rambo42689/Sensor-Estatico/Suporte do Sensor na Bancada (Projeto SOLID)/Suporte Pronto - Bancada Estática.SLDASM

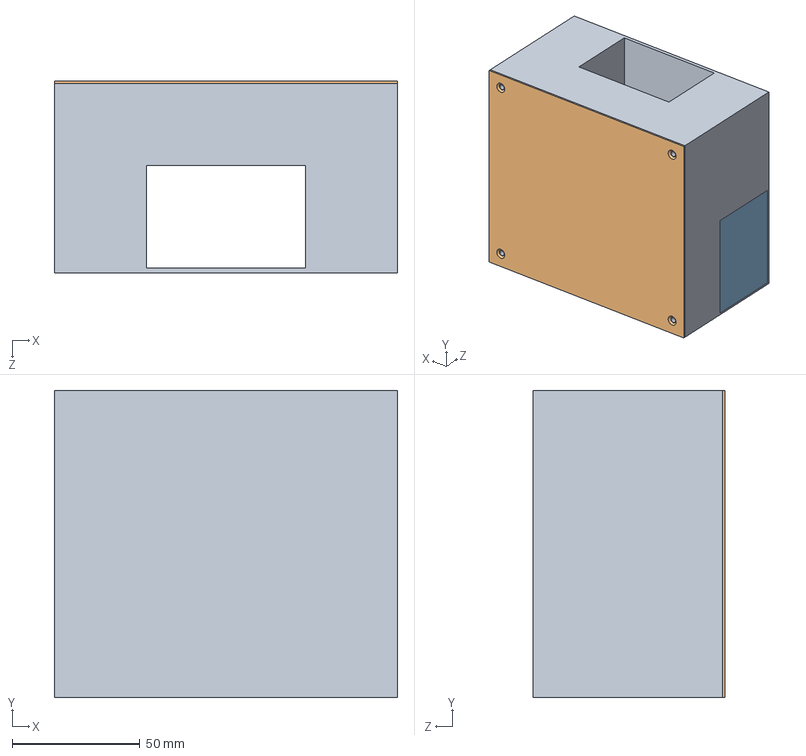
[picture p1: CAD file, 2019-11-12]
Suporte do Sensor na Bancada (Projeto SOLID)/Suporte Pronto - Bancada Estática.SLDASM
134.0 x 120.0 x 75.0 mm
Caixa Principal - Bancada Estática
Tampa Traseira - Bancada Estática
Tampa - Pilha
