rambo42689/Sensor-Estatico/Suporte do Sensor na Bancada (Projeto SOLID)/Caixa Principal - Bancada Estática.SLDPRT

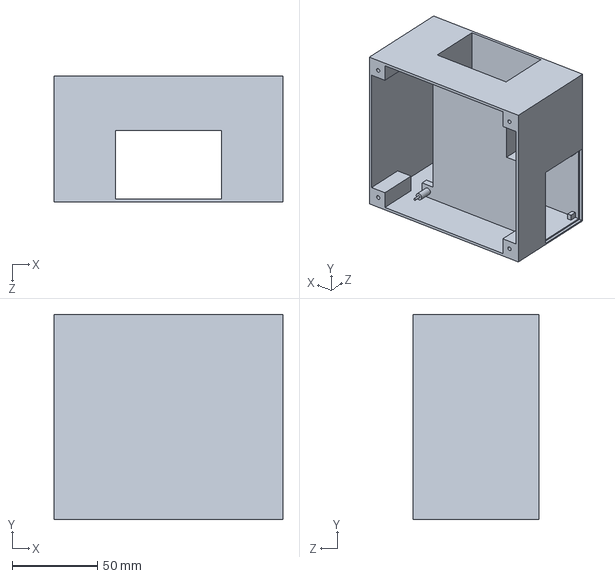
[picture p2: CAD file, 2019-11-12]
Suporte do Sensor na Bancada (Projeto SOLID)/Caixa Principal - Bancada Estática.SLDPRT
134.0 x 120.0 x 74.0 mm
