rambo42689/Sensor-Estatico/Suporte do Sensor na Bancada (Projeto SOLID)/Tampa - Pilha.SLDPRT

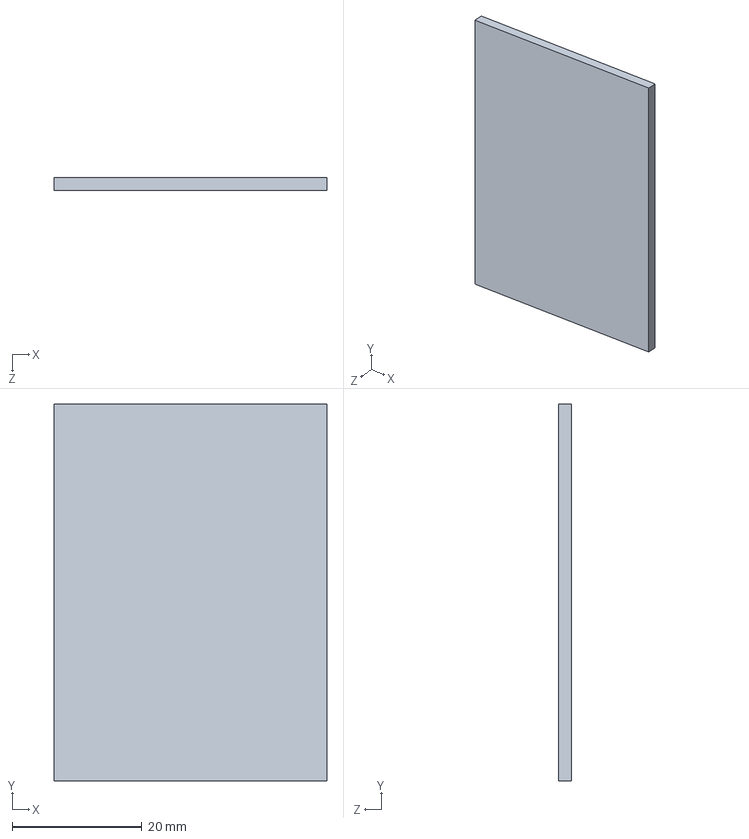
[picture p3: CAD file, 2019-11-12]
Suporte do Sensor na Bancada (Projeto SOLID)/Tampa - Pilha.SLDPRT
42.0 x 58.0 x 2.00 mm
