rambo42689/Sensor-Estatico/Suporte do Sensor na Bancada (Projeto SOLID)/Tampa Traseira - Bancada Estática.SLDPRT

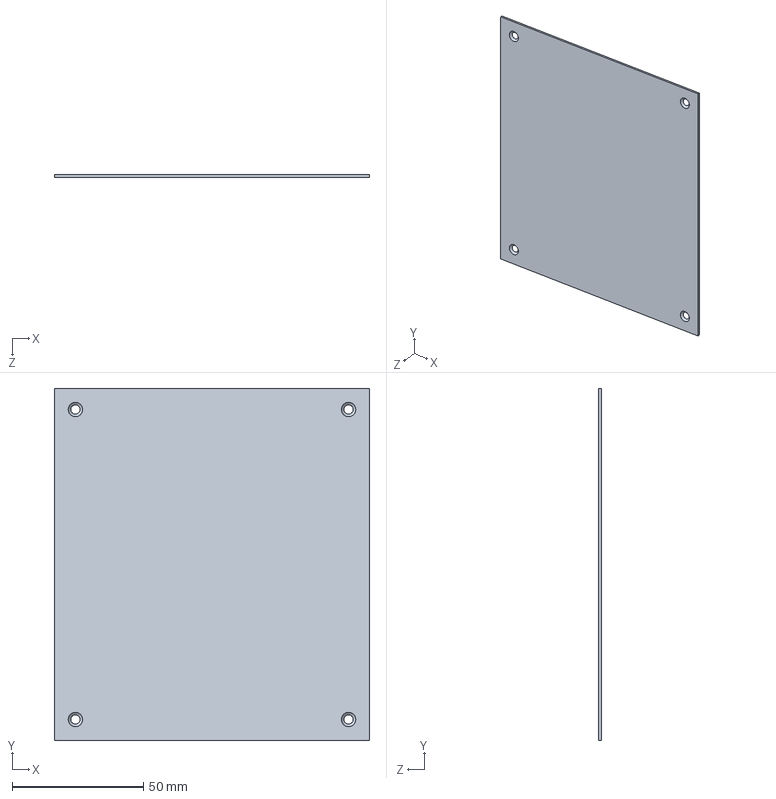
[picture p4: CAD file, 2019-11-12]
Suporte do Sensor na Bancada (Projeto SOLID)/Tampa Traseira - Bancada Estática.SLDPRT
120.0 x 134.0 x 1.00 mm
