rambo42689/Sensor-Estatico/PCB/Design-PCB---Impresso---4-Placas.pdf

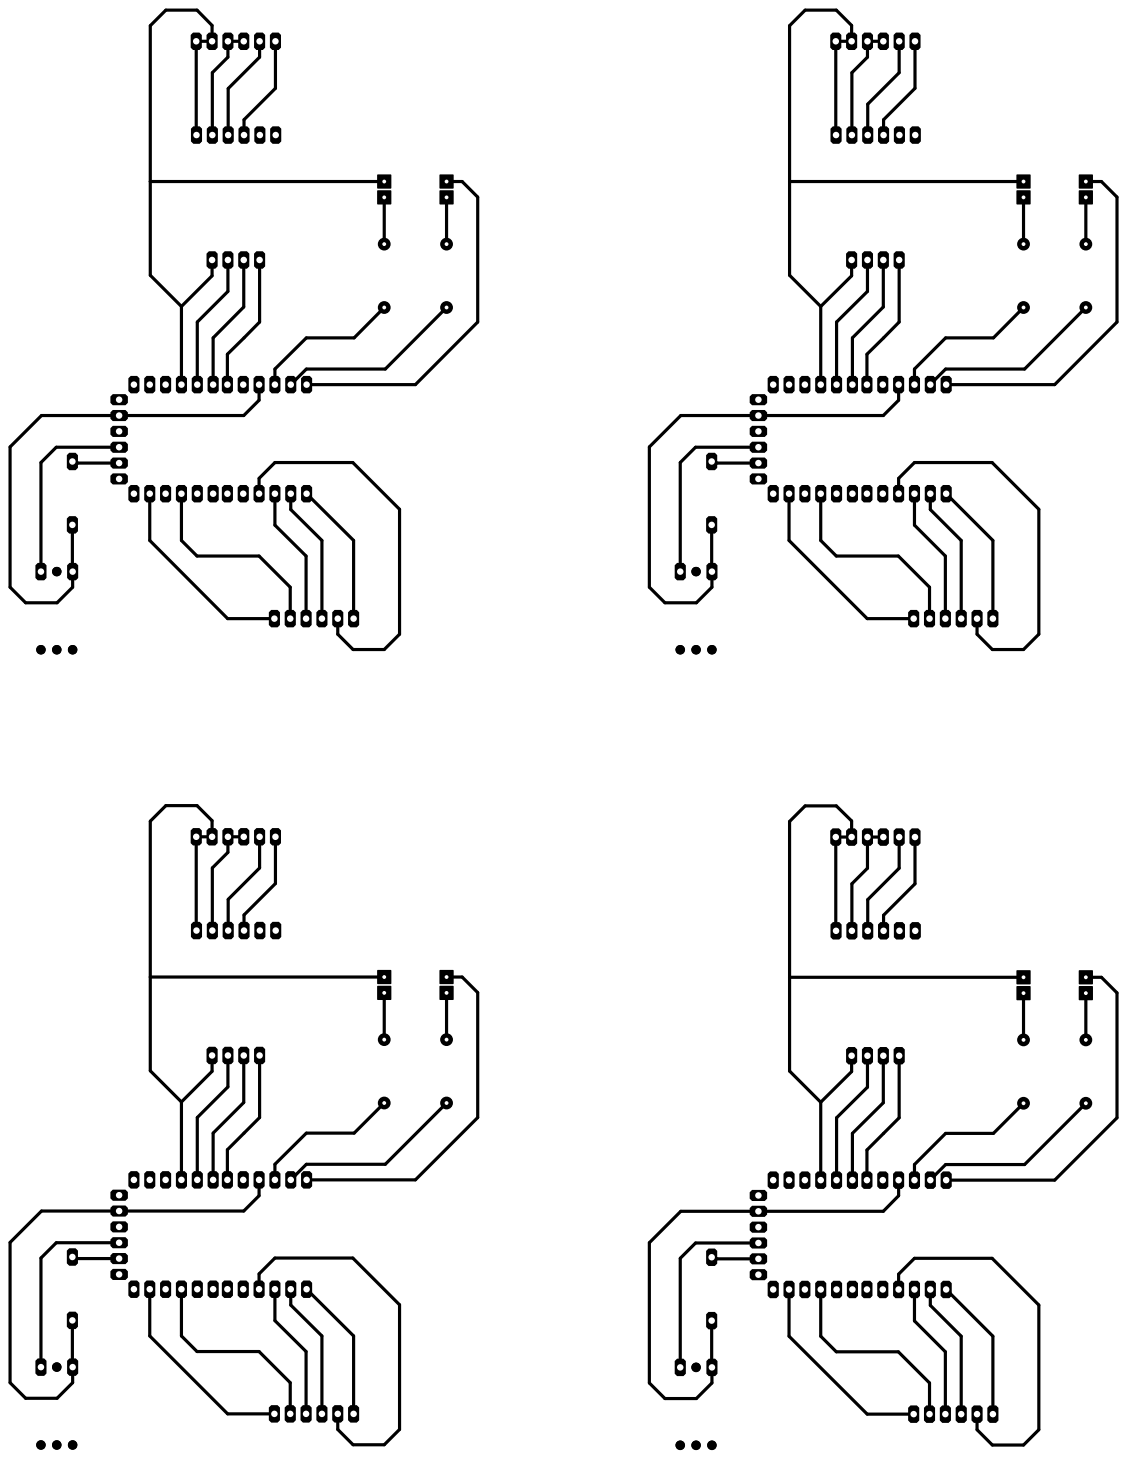
[picture p5: page 1]
