rambo42689/Sensor-Estatico/PCB/Esquema para Impressão (Imagem Espelhada).PDF

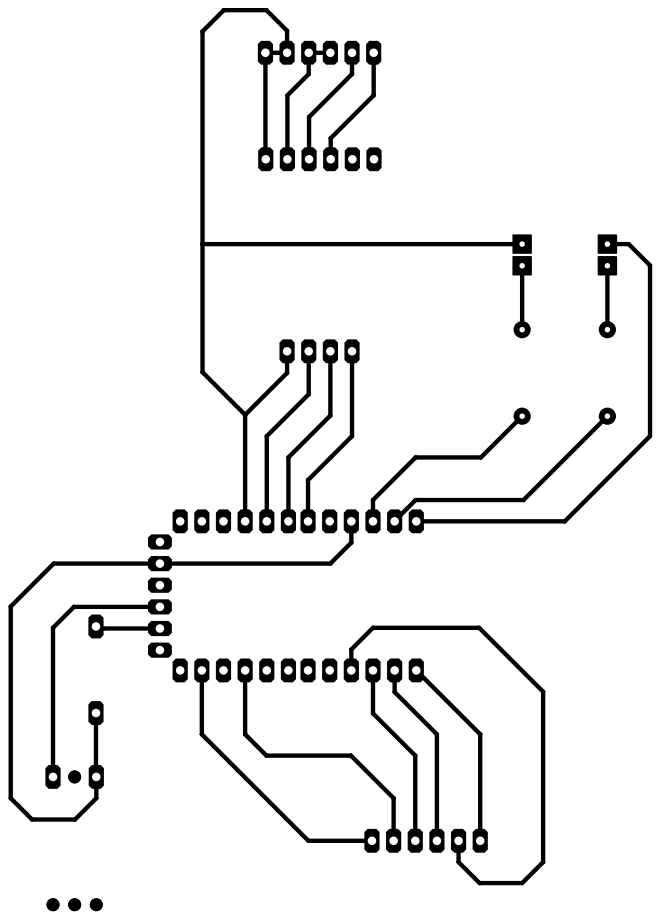
[picture p6: page 1]
