rambo42689/Sensor-Estatico/(list of files, drawings)

Other design files:
PCB/Kosmos.pdsprj
PCB/Sensor Estático Design V04/Sensor Estático V04.pdsprj
PCB/Sensor Estático Design V05/Sensor Estático V04.pdsprj
PCB/Sensor Estático Ultimate.pdsprj
