rambo42689/Sensor-Estatico/(commit log)

2019-11-12 Arquivos iniciais do desenvolvimento do Sensor Estático. Estão incluídas: - 7 primeiras versões de Software, incluindo as "emergenciais" - O projeto modelado do suporte do sensor (para impressão 3D)
    [Caixa Principal - Bancada Estática.SLDPRT, Kosmos.pdsprj, Sensor Estático Ultimate.pdsprj, Sensor Estático V04.pdsprj, Suporte Pronto - Bancada Estática.SLDASM, Tampa - Pilha.SLDPRT, Tampa Traseira - Bancada Estática.SLDPRT]
2019-11-12 Atualização de versão
    Foram removidos as versões antigas dos códigos, assim como os resultados dos Testes Estáticos (estes dados ficaram acessiveis somente no drive)
2019-11-12 "Emergency" code version uploaded
    If the main code fails, and the error cannot be repaired in time, this code was developed to be used those situations. The trigger to activate the SD recording system is "time" triggered, which means, that no INPUT signal is necessary.
    [Code_Sensor_Estatico_V07.ino]
2019-11-12 Code_Sensor_Estatico_Emergency.ino
    Código foi atualizado para descartar váriaveis não utilizadas e foi adicionado um manual no próprio código
2019-11-13 Update Code_Sensor_Estatico_V07.ino
    Foram feitas algumas alterações no código para como tentiva de aumentar a velocidade de gravação
